joergkeller/beehive-sensor/docs/Heltec CubeCell Dev/CubeCell Dev Pinout.png

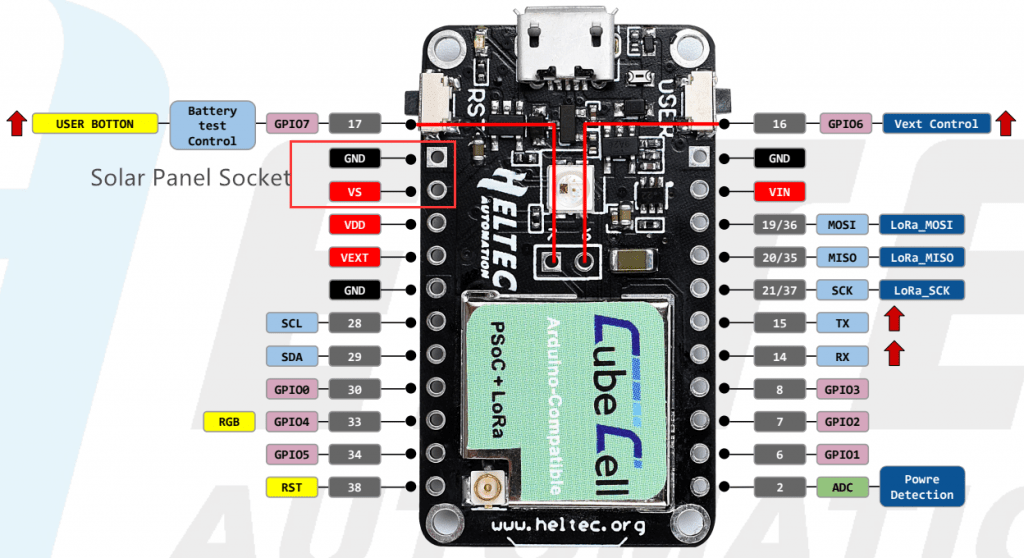
docs/Heltec CubeCell Dev/CubeCell Dev Pinout.png
