joergkeller/beehive-sensor/docs/Dragino LoRa Mini Dev/LoRa_mini_Pinout.png

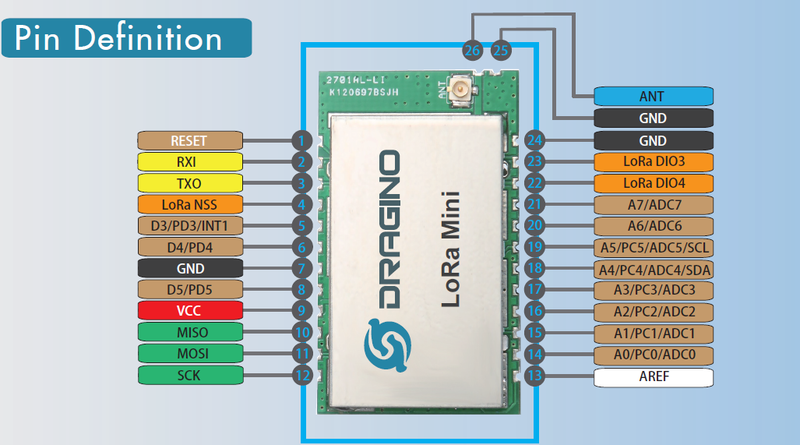
docs/Dragino LoRa Mini Dev/LoRa_mini_Pinout.png
