joergkeller/beehive-sensor/docs/Dragino LoRa Shield/LoRa_Shield_Pin_Mapping.png

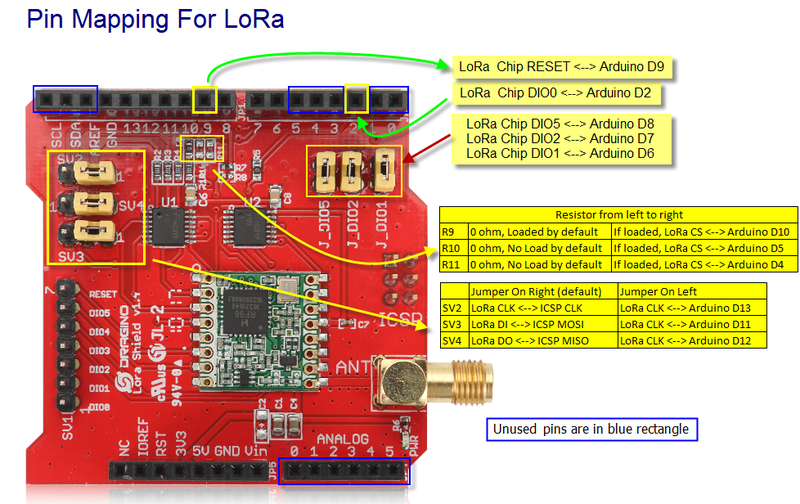
docs/Dragino LoRa Shield/LoRa_Shield_Pin_Mapping.png
