joergkeller/beehive-sensor/docs/Dragino LoRa Mini Dev/LoRa Mini Dev v1.3.sch.pdf

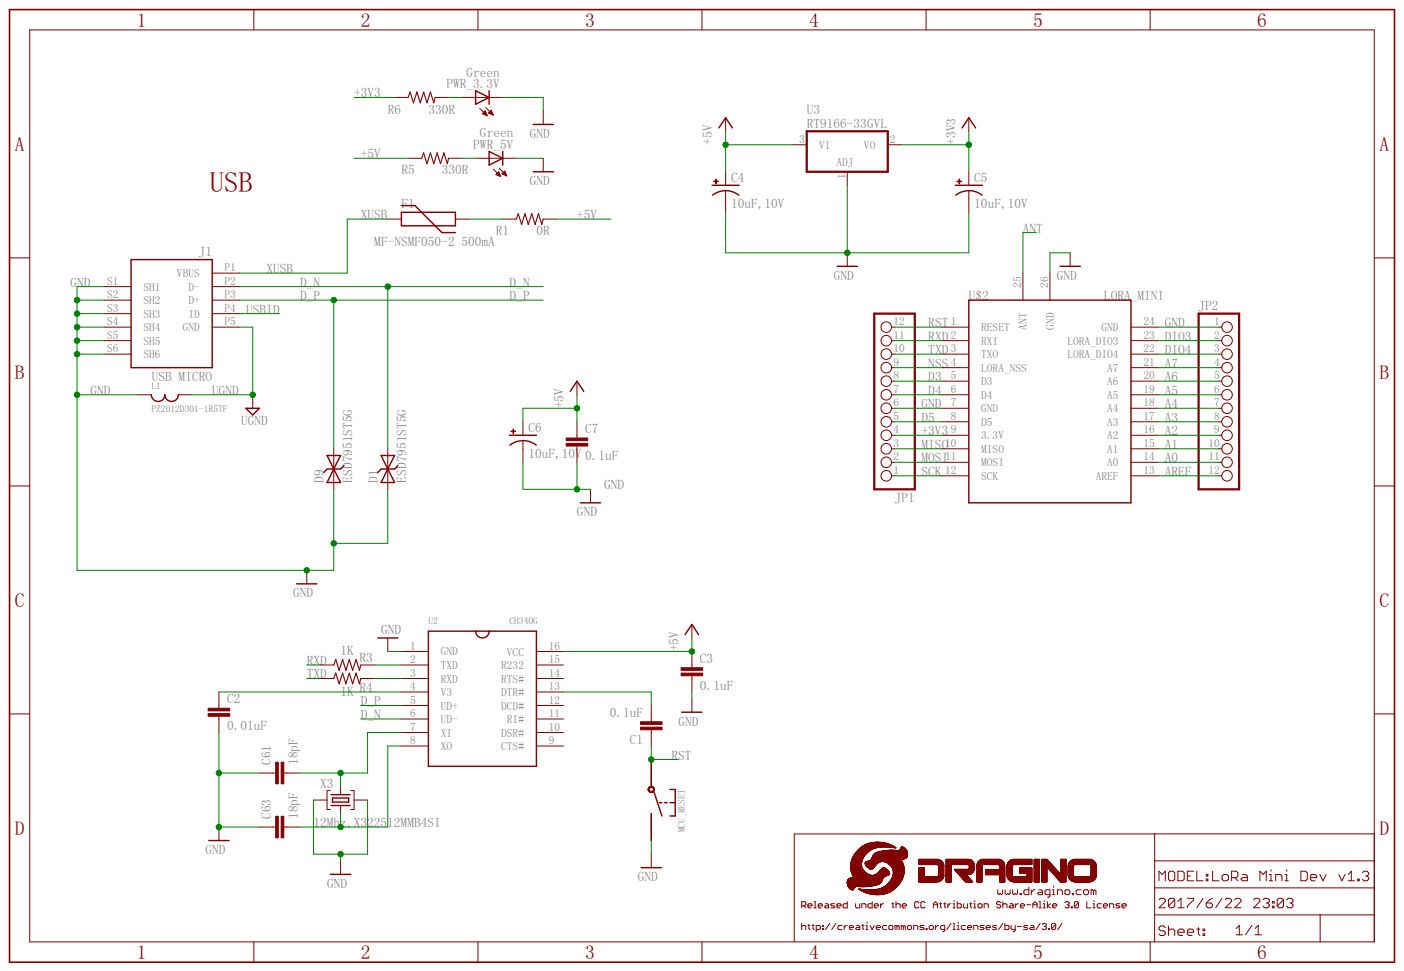
[picture p4: page 1]

Green PWR_3.3V +3V3
