joergkeller/beehive-sensor/(list of files, drawings)

Other design files:
docs/Dragino LoRa Shield/LoRa Shield Sensors.fzz
