joergkeller/beehive-sensor/arduino_beehive_sensor_lora/credentials-template.h

/**********************************************************
 * LoRa credentials for TTN. Rename/copy to credentials.h
 * before inserting the real values.
 **********************************************************/
#ifndef __CREDENTIALS_H__
#define __CREDENTIALS_H__

#if DEVICE_ID == KROKUS // OTAA method

  static uint8_t DEV_EUI[8]  = { 0x00, 0x00, 0x00, 0x00, 0x00, 0x00, 0x00, 0x00 };
  static uint8_t APP_EUI[8]  = { 0x00, 0x00, 0x00, 0x00, 0x00, 0x00, 0x00, 0x00 };
  static uint8_t APP_KEY[16] = { 0x00, 0x00, 0x00, 0x00, 0x00, 0x00, 0x00, 0x00, 0x00, 0x00, 0x00, 0x00, 0x00, 0x00, 0x00, 0x00 };

#elif DEVICE_ID == SHAKRA // OTAA method

  static uint8_t DEV_EUI[8]  = { 0x00, 0x00, 0x00, 0x00, 0x00, 0x00, 0x00, 0x00 };
  static uint8_t APP_EUI[8]  = { 0x00, 0x00, 0x00, 0x00, 0x00, 0x00, 0x00, 0x00 };
  static uint8_t APP_KEY[16] = { 0x00, 0x00, 0x00, 0x00, 0x00, 0x00, 0x00, 0x00, 0x00, 0x00, 0x00, 0x00, 0x00, 0x00, 0x00, 0x00 };

#elif DEVICE_ID == GOTTHARD // OTAA method

  static uint8_t DEV_EUI[8]  = { 0x00, 0x00, 0x00, 0x00, 0x00, 0x00, 0x00, 0x00 };
  static uint8_t APP_EUI[8]  = { 0x00, 0x00, 0x00, 0x00, 0x00, 0x00, 0x00, 0x00 };
  static uint8_t APP_KEY[16] = { 0x00, 0x00, 0x00, 0x00, 0x00, 0x00, 0x00, 0x00, 0x00, 0x00, 0x00, 0x00, 0x00, 0x00, 0x00, 0x00 };

#elif DEVICE_ID == WITCHES // OTAA method

  static uint8_t DEV_EUI[8]  = { 0x00, 0x00, 0x00, 0x00, 0x00, 0x00, 0x00, 0x00 };
  static uint8_t APP_EUI[8]  = { 0x00, 0x00, 0x00, 0x00, 0x00, 0x00, 0x00, 0x00 };
  static uint8_t APP_KEY[16] = { 0x00, 0x00, 0x00, 0x00, 0x00, 0x00, 0x00, 0x00, 0x00, 0x00, 0x00, 0x00, 0x00, 0x00, 0x00, 0x00 };

#elif DEVICE_ID == CUBE_CELL_1 // OTAA method

  static uint8_t DEV_EUI[8]  = { 0x00, 0x00, 0x00, 0x00, 0x00, 0x00, 0x00, 0x00 };
  static uint8_t APP_EUI[8]  = { 0x00, 0x00, 0x00, 0x00, 0x00, 0x00, 0x00, 0x00 };
  static uint8_t APP_KEY[16] = { 0x00, 0x00, 0x00, 0x00, 0x00, 0x00, 0x00, 0x00, 0x00, 0x00, 0x00, 0x00, 0x00, 0x00, 0x00, 0x00 };

#elif DEVICE_ID == TEST_123 // ABP method

  static uint8_t NWKSKEY[16] = { 0x00, 0x00, 0x00, 0x00, 0x00, 0x00, 0x00, 0x00, 0x00, 0x00, 0x00, 0x00, 0x00, 0x00, 0x00, 0x00 };
  static uint8_t APPSKEY[16] = { 0x00, 0x00, 0x00, 0x00, 0x00, 0x00, 0x00, 0x00, 0x00, 0x00, 0x00, 0x00, 0x00, 0x00, 0x00, 0x00 };
  static uint8_t DEVADDR[4]  = { 0x00, 0x00, 0x00, 0x00 };

#endif

#endif
