joergkeller/beehive-sensor/(commit log)

2019-10-25 test & corrections with dragino shield.
    [DraginoLoRa.h, arduino_beehive_sensor_lora.ino]
2019-10-26 DS18B20 temperature sensors (multiple) are read from pin D3
2019-10-26 DHT22 temperature/humidity sensor is read from pin D4
2019-10-26 USB voltage measurement
2019-11-02 weight measured with load cell and HX711 ADC from pins A0/A1
    [Gewicht Eichung Loadcell.xlsx]
2019-11-02 initial setup mode for load cell calibration and temperature sensor identification
2019-11-03 request LoRa confirmation, ignore undefined values, send both ThingSpeak and full sensor data in decoded structure
2019-11-03 extract sensor acquisition code to SensorReader and calibration
2019-11-05 wait for tx-pending, print state change notifications
2019-11-10 wiring documentation for dragino shield and lora mini (no coding diffs, same pins can be used)
    [LoRa Shield Sensors.fzz]
2019-11-11 cleanup arduino-lmic
2019-11-12 short measure interval, only send if changes above threshold (or unconditional interval)
    [arduino_beehive_sensor_lora.ino]
2019-11-12 temperature sensor precision 12 bit
2019-12-27 Squashed commit of the following:
    commit a25bb9750a3cead858aee8f7a9ae6c1d97bc37ea
    Author: jokel <joerg.p.keller@gmail.com>
    Date: Fri Dec 27 19:43:18 2019 +0100
    updated CubeCell firmware
    commit 71ad22f42a743ca433fca01ed758f7569d87b290
    Author: jokel <joerg.p.keller@gmail.com>
    Date: Fri Dec 27 01:35:01 2019 +0100
    single source for CubeCell/Dragino
    commit 8d98f3d90eb5fcb82646630fc81f3740df5080c6
    Author: jokel <joerg.p.keller@gmail.com>
    Date: Tue Dec 24 15:41:27 2019 +0100
    otaa activation, resulting SF8 instead of SF12
    commit 59fcf3014bc2967e20653b76a77672e9ea2470cf
    Author: jokel <joerg.p.keller@gmail.com>
    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
    [Battery Voltage spinning.xlsx]
2020-01-04 fixed initialization and calling of handler
    [StateMachine.h, arduino_beehive_sensor_lora.ino]
2020-01-12 Feature/manual button (#1)
    * manual-mode state with switch and led
    * manual-mode state reads raw data, setup state obsolete
    * adoption to cubecell
    [LoRa Shield Sensors.fzz]
2020-01-23 recording sensor data in doc-storage (dynamo-db)
2020-02-02 visualize sensor data (draft)
2020-02-12 multi-day view for all charts, current values in titles
2020-02-19 local time, query param for device, setting and timestamp info
2020-03-08 checked board pins, separate table
2020-03-08 added wiring details (pull-up)
2020-04-09 fixed: battery measure reuses GPIO7 as ADC_CTL and caused a user button event (#2)
    [SensorReader.h, arduino_beehive_sensor_lora.ino]
2020-04-09 Feature/red pixel in manual mode (#3)
    * allow to switch on LORAWAN_RGB neo pixel, show red pixel blinking in manual mode
    * correct definition string used (case sensitive)
    [Interaction.h, arduino_beehive_sensor_lora.ino]
2020-04-09 Feature/temperature compensation (#4)
    * temperature compensation of weight
    * print name of stale state transition
    * fixed: battery measure reuses GPIO7 as ADC_CTL and caused a user button event (#2)
    * temperature compensation of weight
    * Feature/red pixel in manual mode (#3)
    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
    [Gewicht Eichung Loadcell.xlsx]
2020-04-09 updated arduino setup
2020-04-13 scripts for arduino-cli
2020-04-13 scripts for arduino-cli, workflow test action
2020-04-13 corrections for test run
    [Gewicht Eichung Loadcell.xlsx]
2020-04-13 more temperature sensors, changed message structure
2020-04-13 more temperature sensors, changed message structure with corrected decoder script
    [arduino_beehive_sensor_lora.ino]
2020-04-14 refactored temperature readings, simpler to change number of 1-wire sensors
2020-04-14 different creditials and calibrations for multiple devices in same code base
2020-04-15 device handling in lambda function
2020-04-20 additional hints for weight calibration
    [Gewicht Eichung Loadcell.xlsx]
2020-04-22 debug output for temperature sensors
2020-04-24 adopt to actual sensor ids
2020-05-03 display additional sensor data
2020-05-04 numeric definition of devices instead of literals; calibration of parallel load cells (shakra)
    [Gewicht Eichung Loadcell.xlsx]
2020-05-16 calibration values as real examples
    [Gewicht Eichung Loadcell.xlsx]
2020-08-31 update to CubeCell 0.0.6 - renamed AdaFruit_NeoPixel - renamed ADC_CTL - fixed HX711, shiftIn not available anymore (?)
    [Interaction.h, SensorReader.h]
2020-08-31 compile-check on Arduino UNO
2020-09-13 Current version CubeCell board, unix development environment
2020-09-13 check scale is ready, ask for confirmation after interval, reset if confirmation fails several times, reset after interval anyway
    [SensorReader.h, arduino_beehive_sensor_lora.ino]
2020-09-13 corrected original board name
2020-09-13 optimized sketch size for Dragino boards
2021-01-28 Feature/update versions (#10)
    * update setup-arduino-cli to 1.1.1
    * npm update
    * update CubeCell core to 1.2.0, change compile board settings
2021-11-13 switch the things network from v2 to v3 stack, handling both formats in transition phase
